rabia-akhtar/cat-wheel-print-plates/treat dispenser/main-cap-front.stl

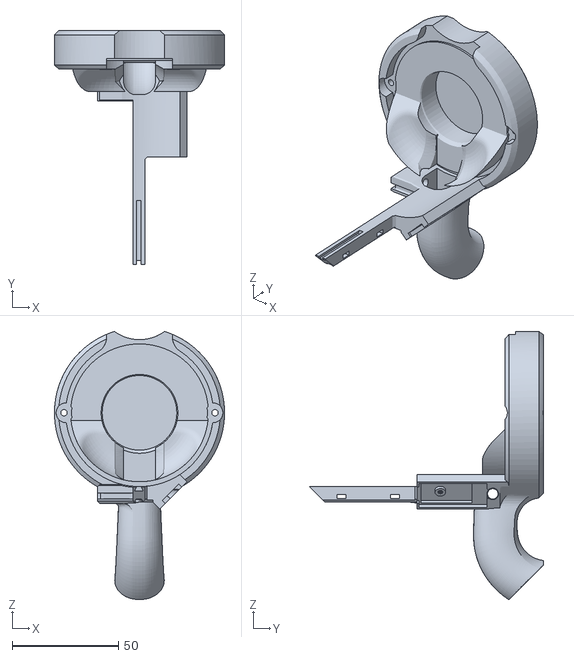
[picture p4: CAD file, 2026-05-28]
treat dispenser/main-cap-front.stl
80.0 x 109.8 x 126.0
