rabia-akhtar/cat-wheel-print-plates/treat dispenser/main-body.stl

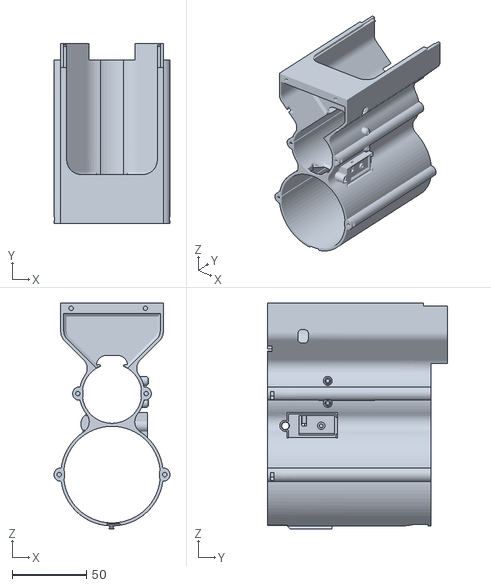
[picture p5: CAD file, 2026-05-28]
treat dispenser/main-body.stl
78.0 x 121.1 x 152.0
