rabia-akhtar/cat-wheel-print-plates/magnet sense/magnet_clip.stl

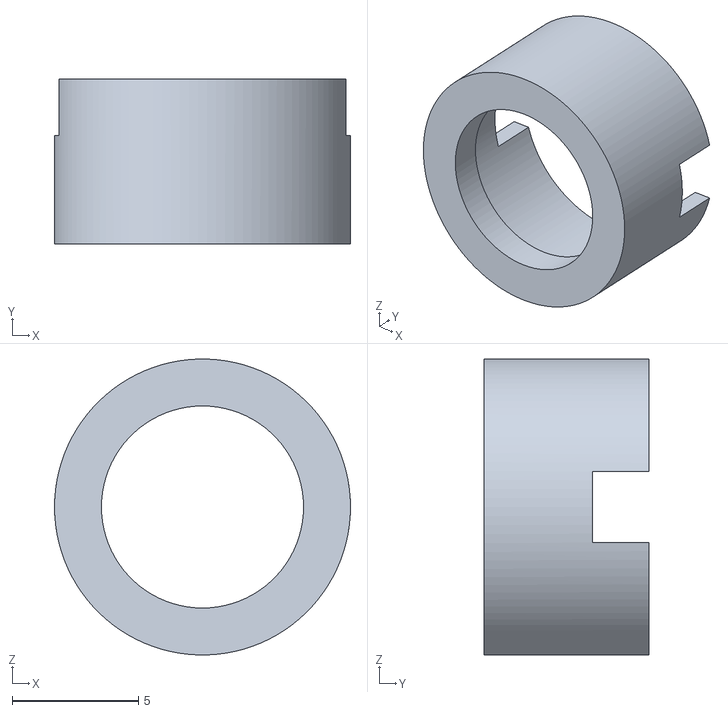
[picture p6: CAD file, 2026-05-28]
magnet sense/magnet_clip.stl
11.7 x 6.55 x 11.7
