rabia-akhtar/cat-wheel-print-plates/plates/plate_1.stl

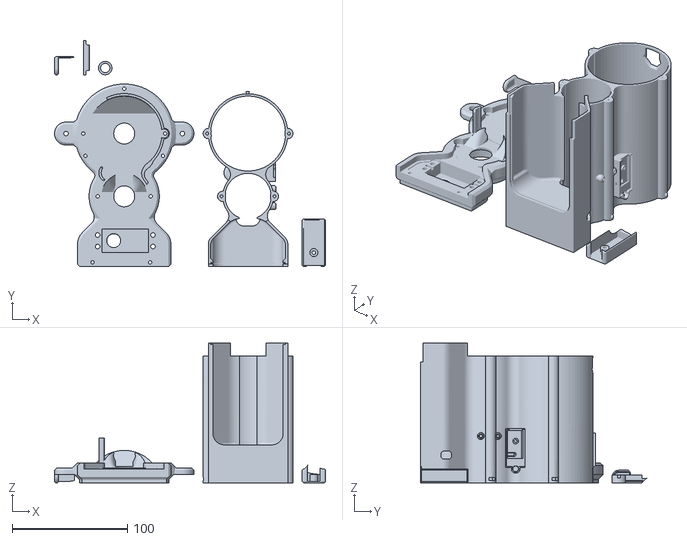
[picture p7: CAD file, 2026-05-28]
plates/plate_1.stl
235.2 x 196.2 x 121.1
