rabia-akhtar/cat-wheel-print-plates/treat dispenser/arduino-holder.stl

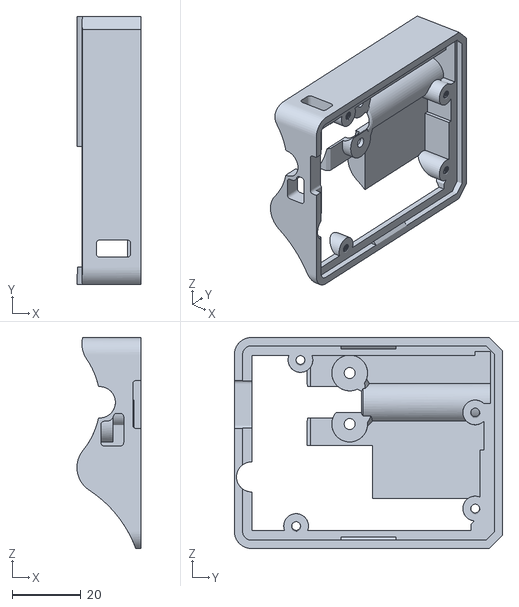
[picture p8: CAD file, 2026-05-28]
treat dispenser/arduino-holder.stl
18.6 x 78.0 x 61.3
