rabia-akhtar/cat-wheel-print-plates/wheel mount/letter-9-cat-t.stl

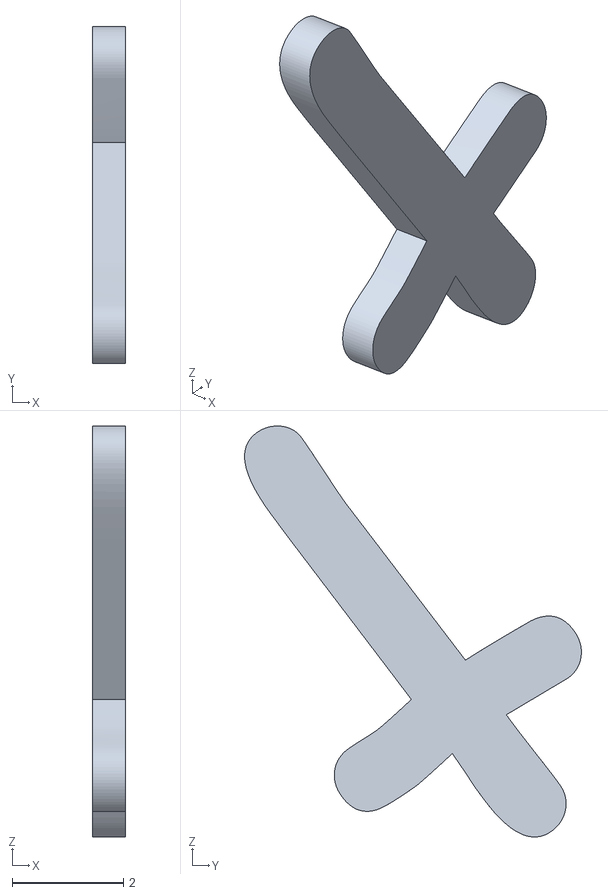
[picture p9: CAD file, 2026-05-28]
wheel mount/letter-9-cat-t.stl
0.6 x 6.05 x 7.38
