rabia-akhtar/cat-wheel-print-plates/magnet sense/hall_effect_holder.stl

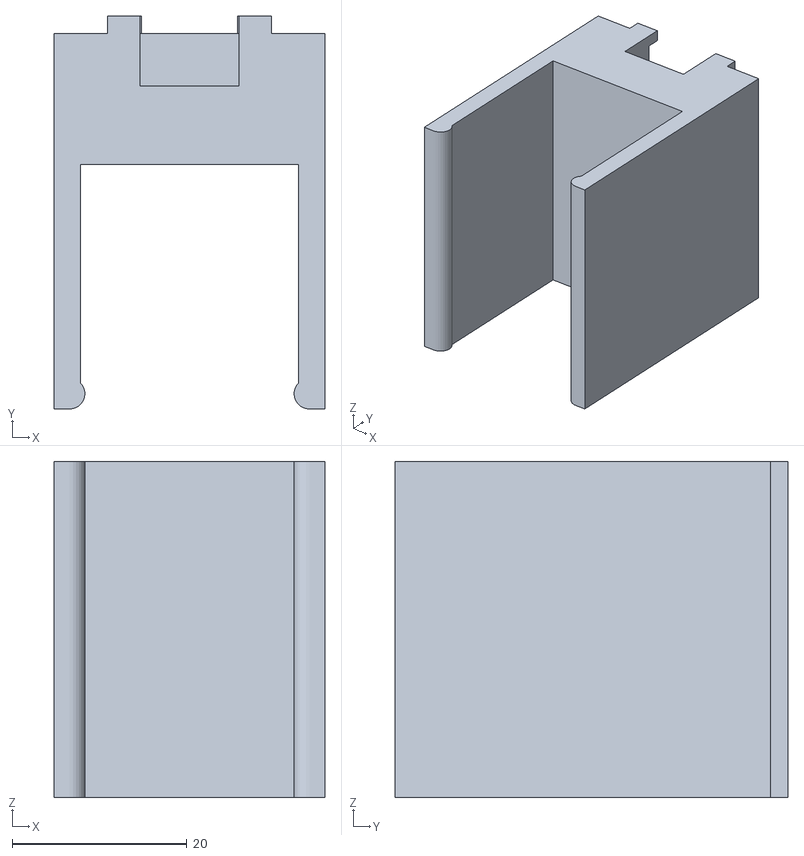
[picture p10: CAD file, 2026-05-28]
magnet sense/hall_effect_holder.stl
31.0 x 45.0 x 38.5
