rabia-akhtar/cat-wheel-print-plates/plates/plate_5.stl

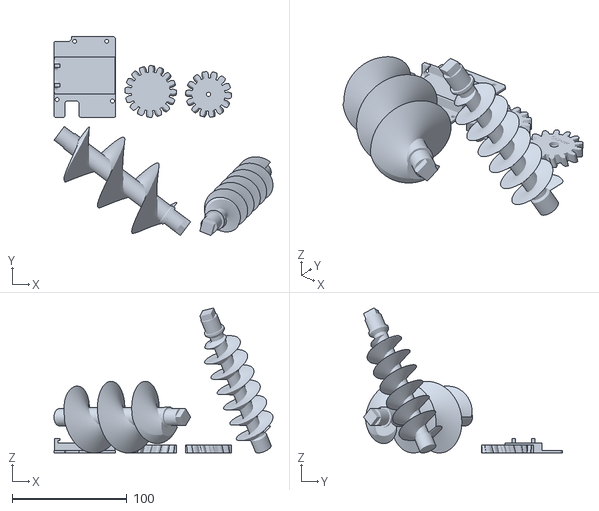
[picture p11: CAD file, 2026-05-28]
plates/plate_5.stl
190.9 x 173.5 x 126.4
