rabia-akhtar/cat-wheel-print-plates/treat dispenser/esp32-wroom-sled.stl

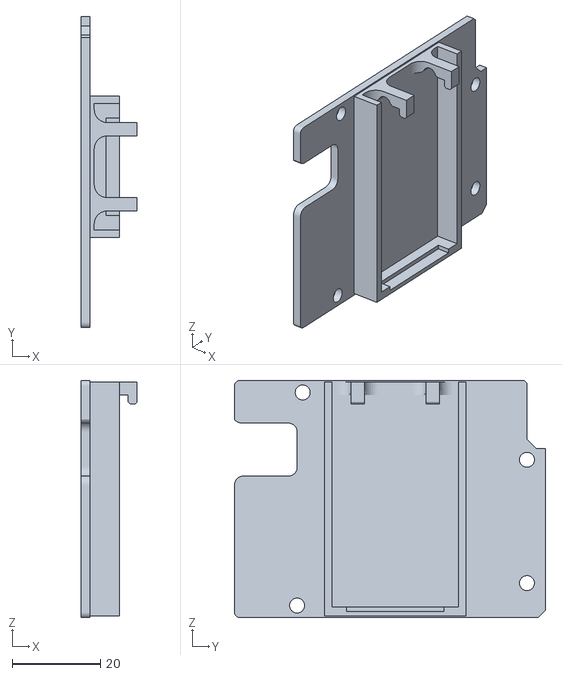
[picture p12: CAD file, 2026-05-28]
treat dispenser/esp32-wroom-sled.stl
12.7 x 70.4 x 53.7
