rabia-akhtar/cat-wheel-print-plates/wheel mount/front.stl

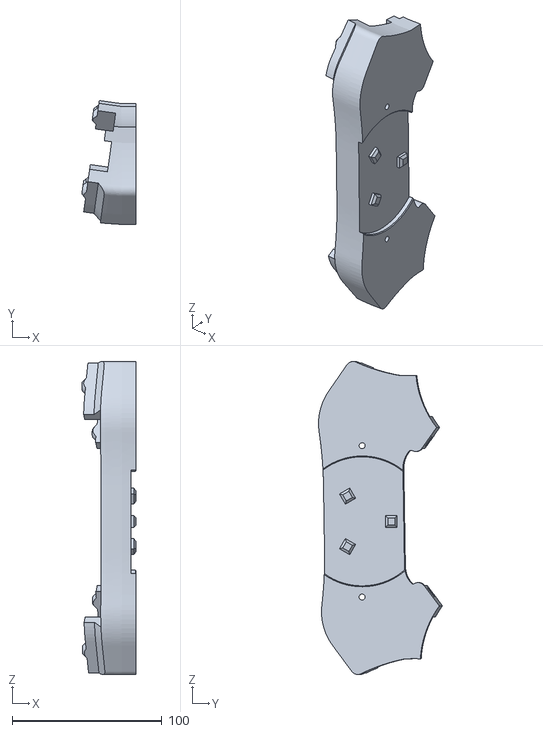
[picture p13: CAD file, 2026-05-28]
wheel mount/front.stl
36.3 x 82.7 x 208.9
