rabia-akhtar/cat-wheel-print-plates/plates/plate_4.stl

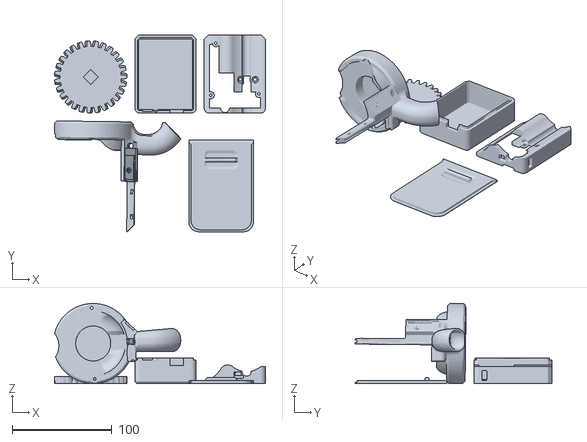
[picture p14: CAD file, 2026-05-28]
plates/plate_4.stl
211.2 x 196.7 x 80.1
