rabia-akhtar/cat-wheel-print-plates/treat dispenser/arduino-cover.stl

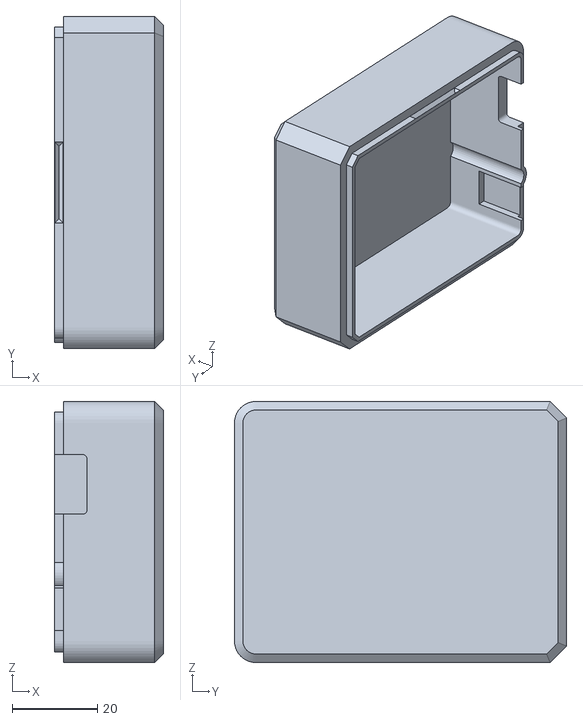
[picture p15: CAD file, 2026-05-28]
treat dispenser/arduino-cover.stl
25.5 x 78.0 x 61.3
