rabia-akhtar/cat-wheel-print-plates/wheel mount/letter-1-one-o.stl

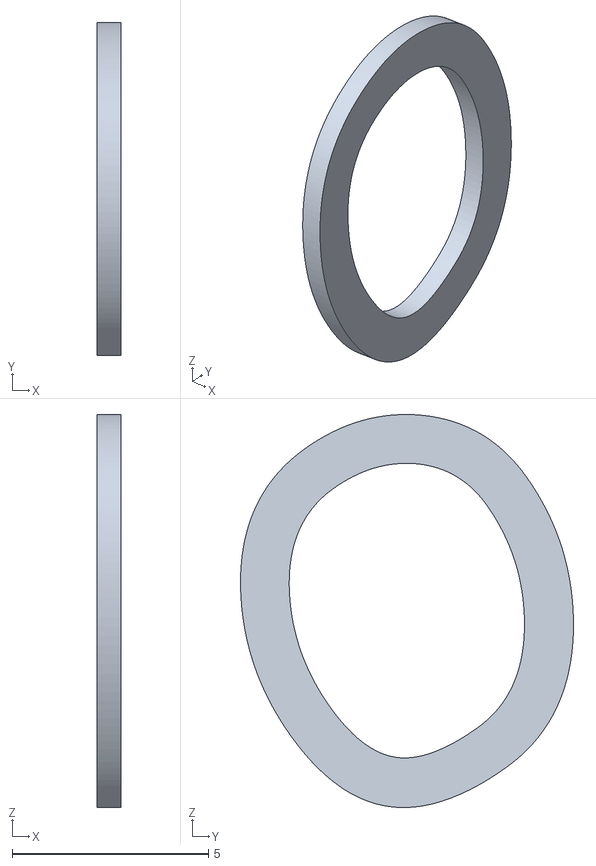
[picture p16: CAD file, 2026-05-28]
wheel mount/letter-1-one-o.stl
0.6 x 8.49 x 10.0
