rabia-akhtar/cat-wheel-print-plates/plates/plate_2.stl

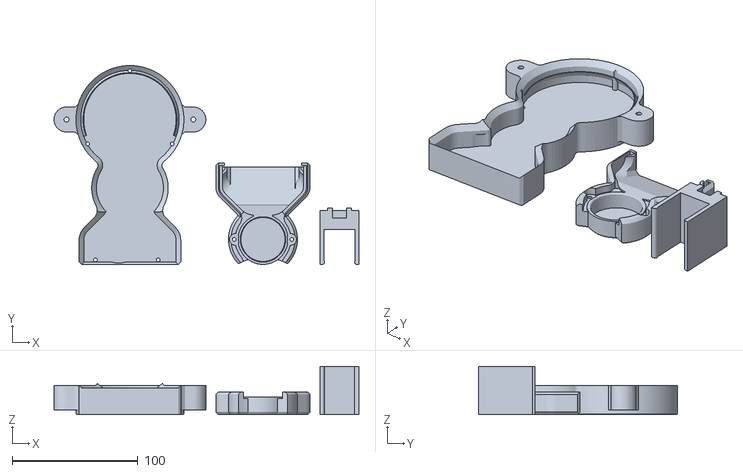
[picture p17: CAD file, 2026-05-28]
plates/plate_2.stl
243.0 x 158.4 x 38.5
