rabia-akhtar/cat-wheel-print-plates/wheel mount/back.stl

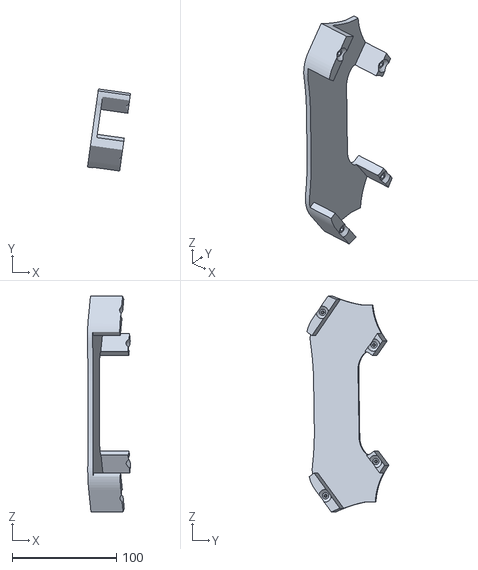
[picture p18: CAD file, 2026-05-28]
wheel mount/back.stl
41.3 x 78.7 x 207.0
