rabia-akhtar/cat-wheel-print-plates/plates/plate_3.stl

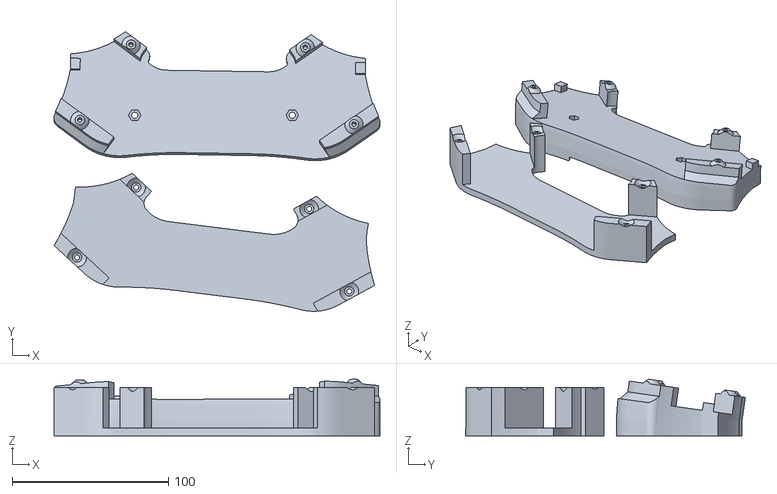
[picture p19: CAD file, 2026-05-28]
plates/plate_3.stl
208.9 x 179.3 x 36.3
