rabia-akhtar/cat-wheel-print-plates/treat dispenser/gear-cover.stl

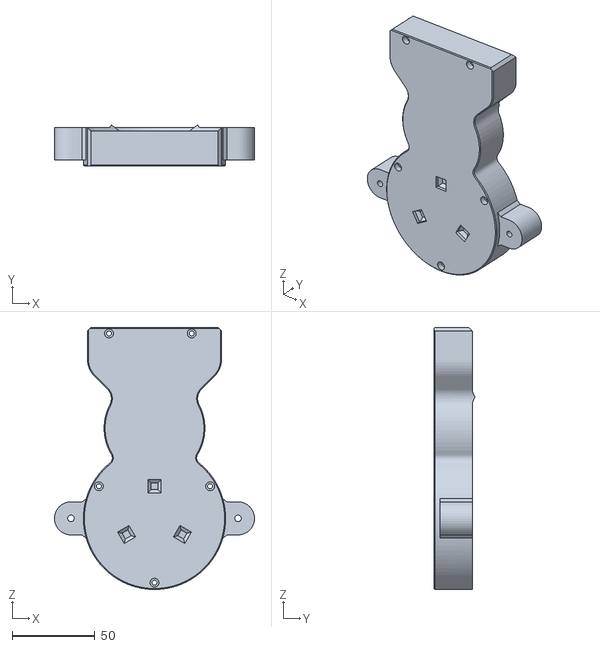
[picture p20: CAD file, 2026-05-28]
treat dispenser/gear-cover.stl
121.0 x 24.9 x 158.4
