rabia-akhtar/cat-wheel-print-plates/treat dispenser/bottom-gear.stl

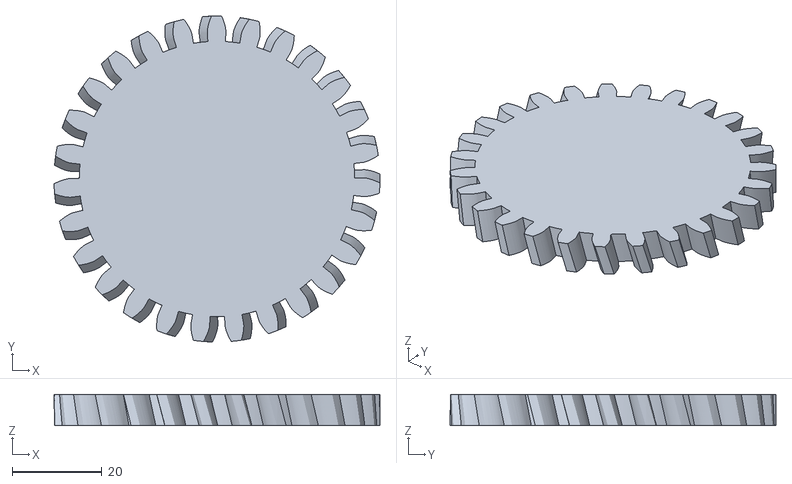
[picture p21: CAD file, 2026-05-28]
treat dispenser/bottom-gear.stl
72.5 x 72.5 x 7.00
