rabia-akhtar/cat-wheel-print-plates/wheel mount/letter-5-fat-a.stl

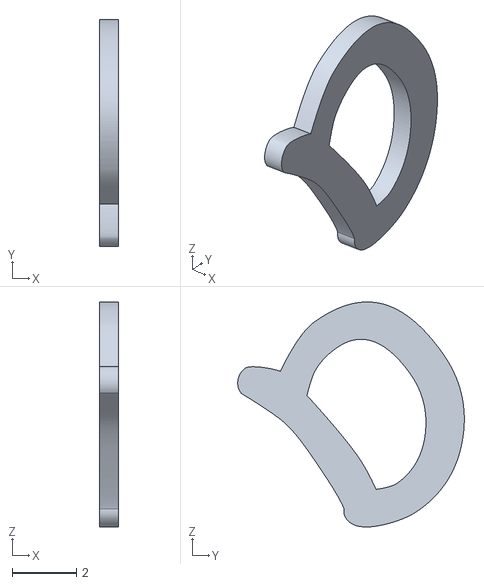
[picture p22: CAD file, 2026-05-28]
wheel mount/letter-5-fat-a.stl
0.6 x 7.08 x 7.03
