rabia-akhtar/cat-wheel-print-plates/treat dispenser/hopper-cap-front.stl

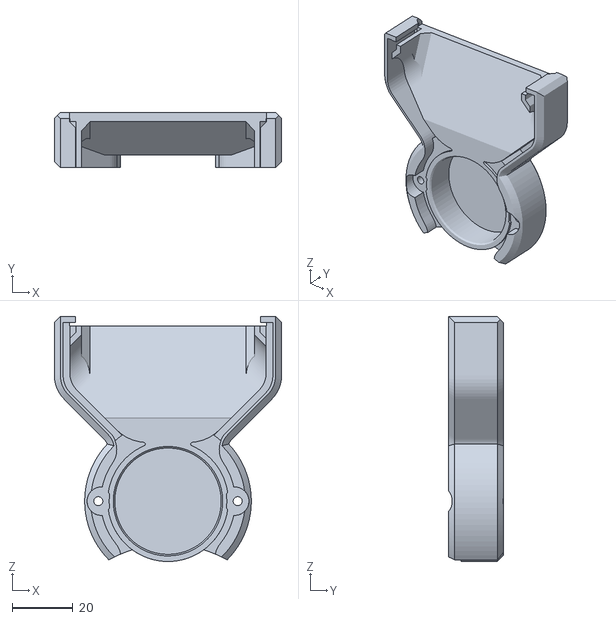
[picture p23: CAD file, 2026-05-28]
treat dispenser/hopper-cap-front.stl
75.0 x 18.1 x 80.8
