rabia-akhtar/cat-wheel-print-plates/wheel mount/letter-2-one-n.stl

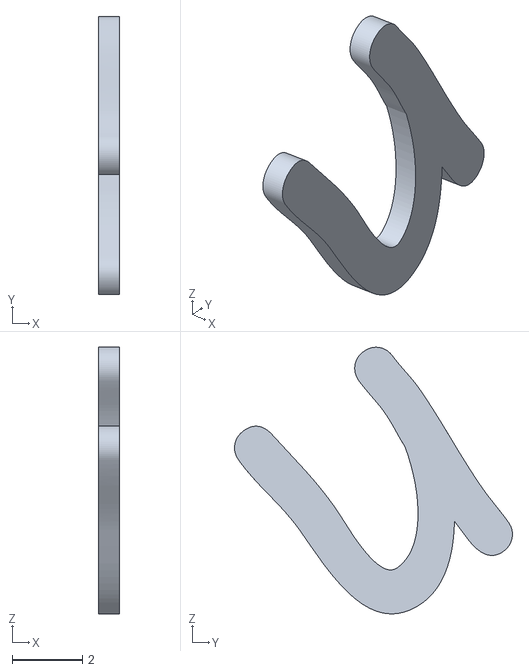
[picture p24: CAD file, 2026-05-28]
wheel mount/letter-2-one-n.stl
0.6 x 7.91 x 7.59
