rabia-akhtar/cat-wheel-print-plates/treat dispenser/drive-gear.stl

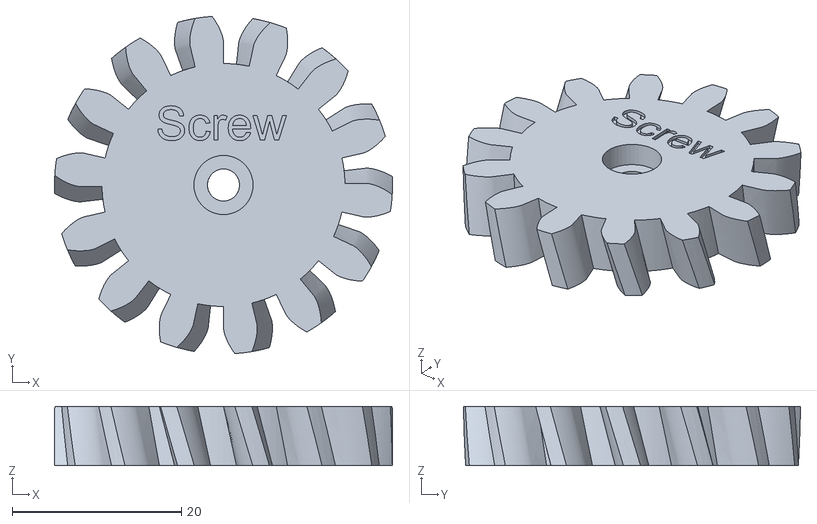
[picture p25: CAD file, 2026-05-28]
treat dispenser/drive-gear.stl
40.0 x 39.9 x 7.00
