rabia-akhtar/cat-wheel-print-plates/wheel mount/letter-7-cat-c.stl

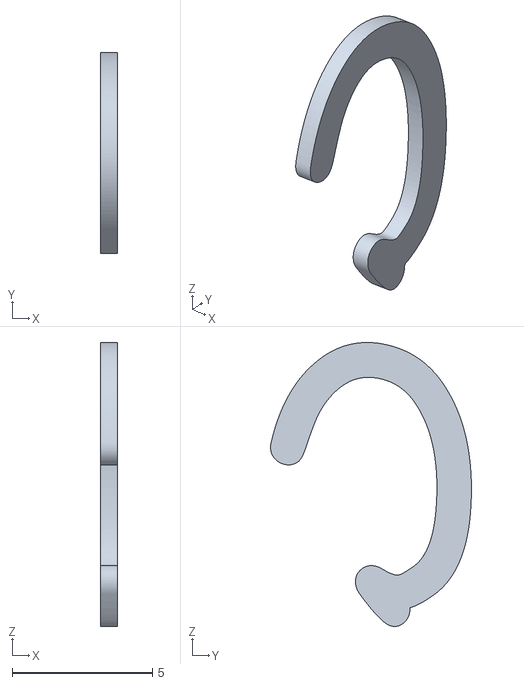
[picture p26: CAD file, 2026-05-28]
wheel mount/letter-7-cat-c.stl
0.6 x 7.17 x 10.1
