rabia-akhtar/cat-wheel-print-plates/treat dispenser/led-cover.stl

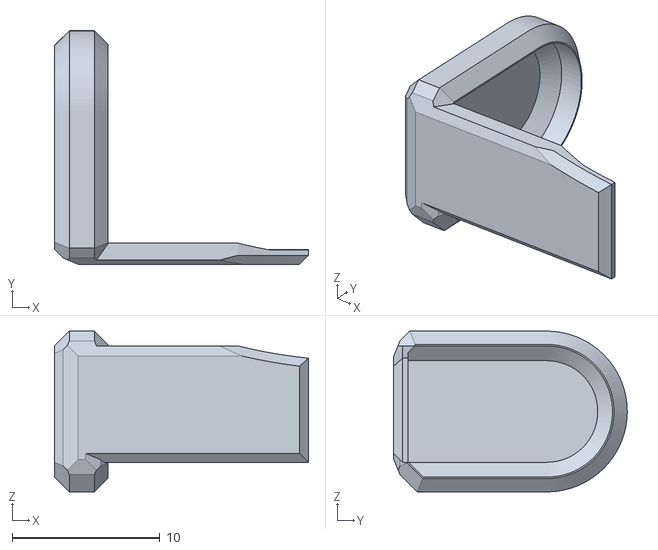
[picture p27: CAD file, 2026-05-28]
treat dispenser/led-cover.stl
17.2 x 15.8 x 10.9
