rabia-akhtar/cat-wheel-print-plates/treat dispenser/esp32-wroom-sled-clip.stl

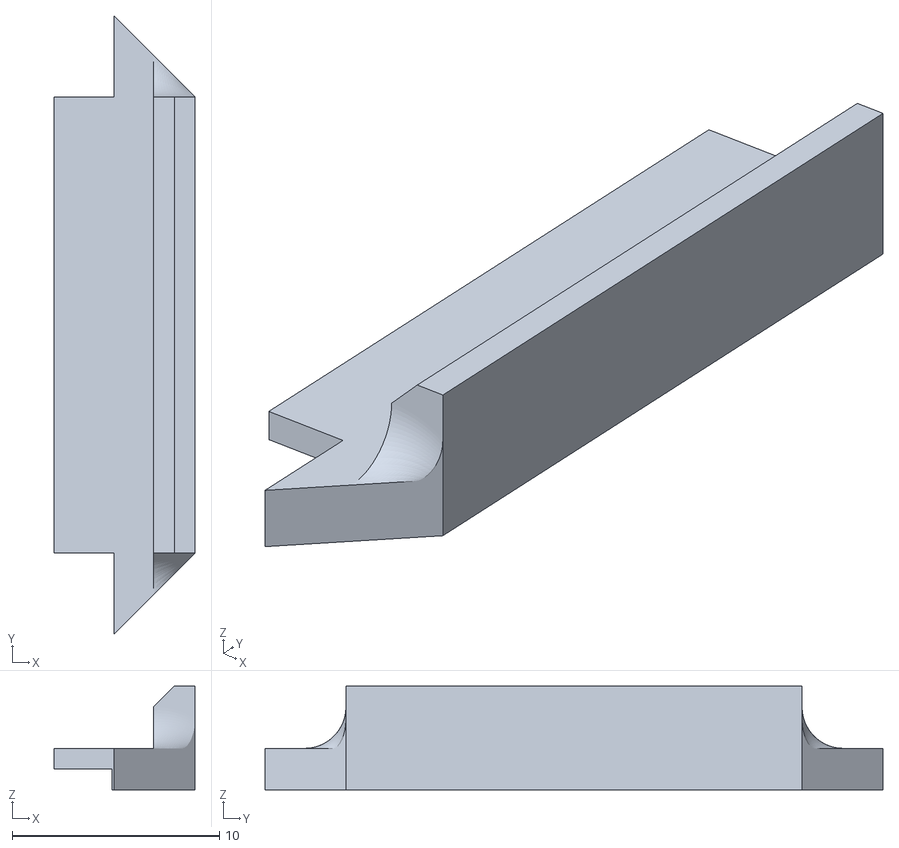
[picture p28: CAD file, 2026-05-28]
treat dispenser/esp32-wroom-sled-clip.stl
6.80 x 29.8 x 5.00
