rabia-akhtar/cat-wheel-print-plates/wheel mount/letter-3-one-e.stl

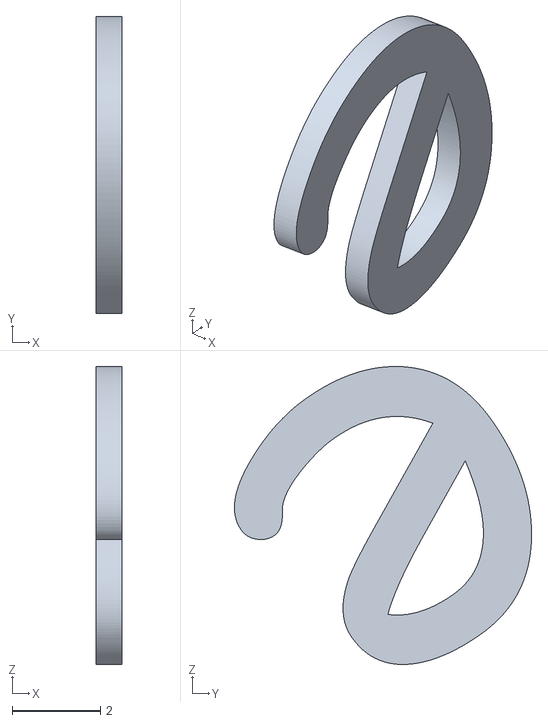
[picture p29: CAD file, 2026-05-28]
wheel mount/letter-3-one-e.stl
0.6 x 6.73 x 6.75
