rabia-akhtar/cat-wheel-print-plates/wheel mount/cat-mount-minimized.step

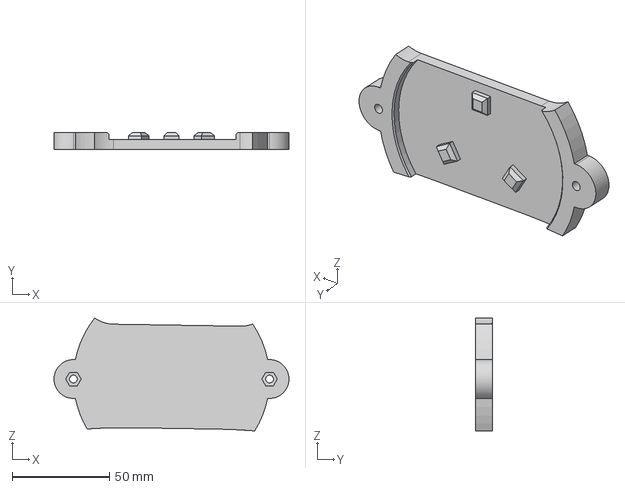
[picture p30: CAD file, 2026-05-28]
wheel mount/cat-mount-minimized.step
121.0 x 8.60 x 58.1 mm
