rabia-akhtar/cat-wheel-print-plates/treat dispenser/hopper-gear.stl

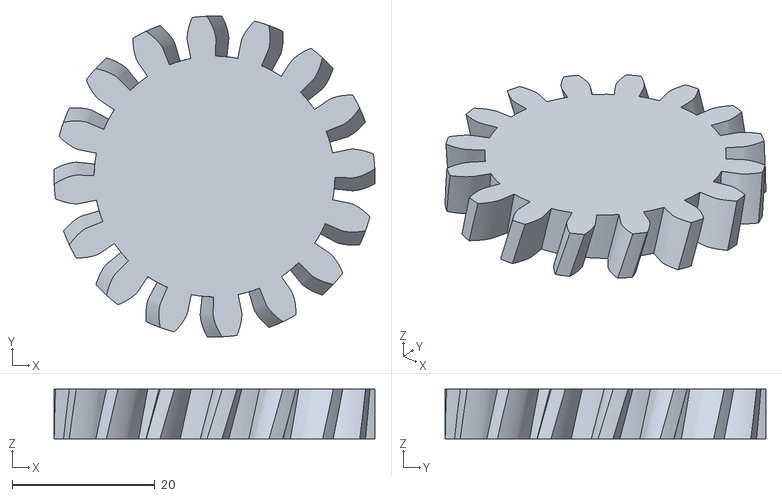
[picture p31: CAD file, 2026-05-28]
treat dispenser/hopper-gear.stl
45.0 x 45.0 x 7.00
