rabia-akhtar/cat-wheel-print-plates/wheel mount/letter-4-fat-f.stl

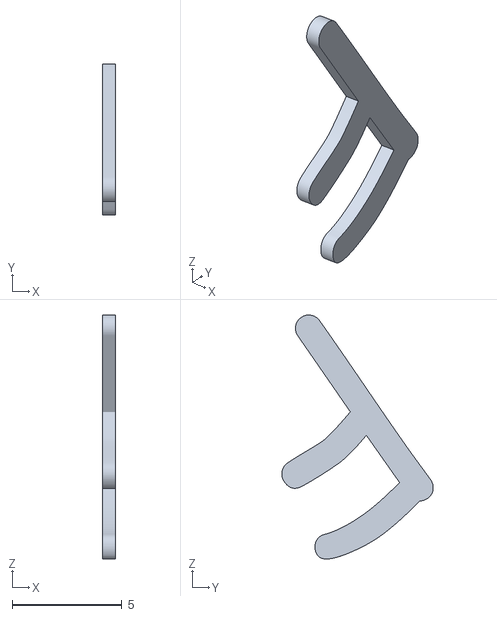
[picture p32: CAD file, 2026-05-28]
wheel mount/letter-4-fat-f.stl
0.6 x 6.91 x 11.1
