rabia-akhtar/cat-wheel-print-plates/treat dispenser/light-break-sensor-cover.stl

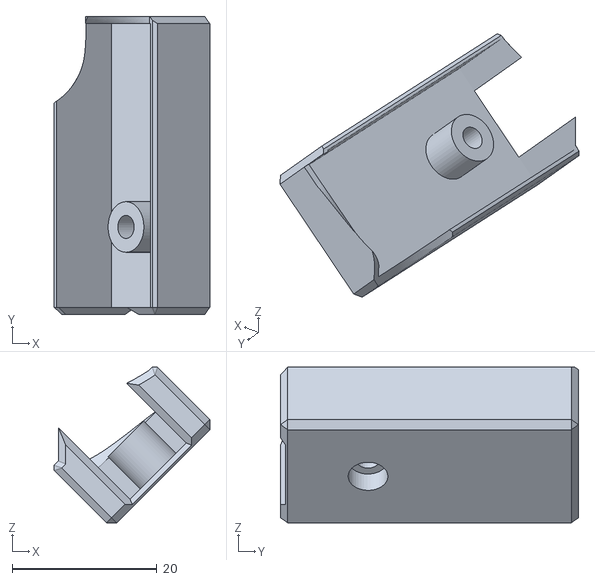
[picture p33: CAD file, 2026-05-28]
treat dispenser/light-break-sensor-cover.stl
21.5 x 41.2 x 21.5
