rabia-akhtar/cat-wheel-print-plates/treat dispenser/back-cap.stl

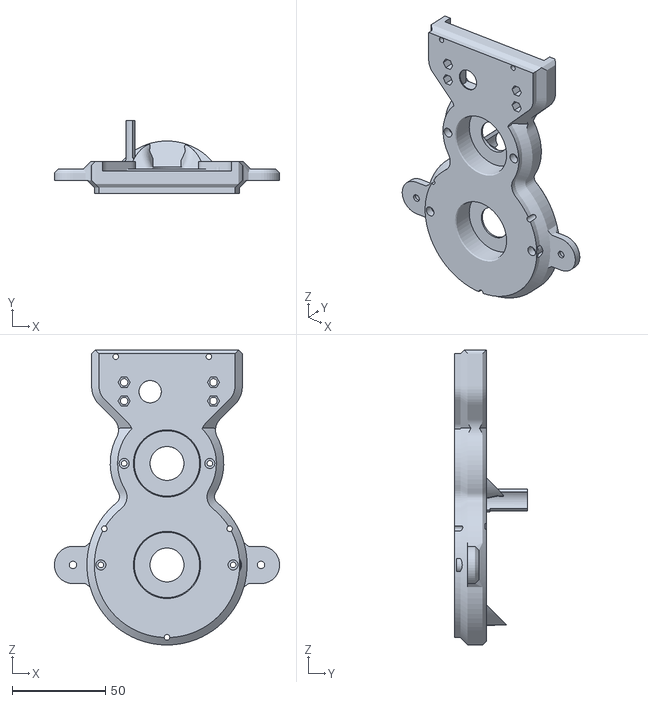
[picture p34: CAD file, 2026-05-28]
treat dispenser/back-cap.stl
121.0 x 39.0 x 158.4
