rabia-akhtar/cat-wheel-print-plates/treat dispenser/lid.stl

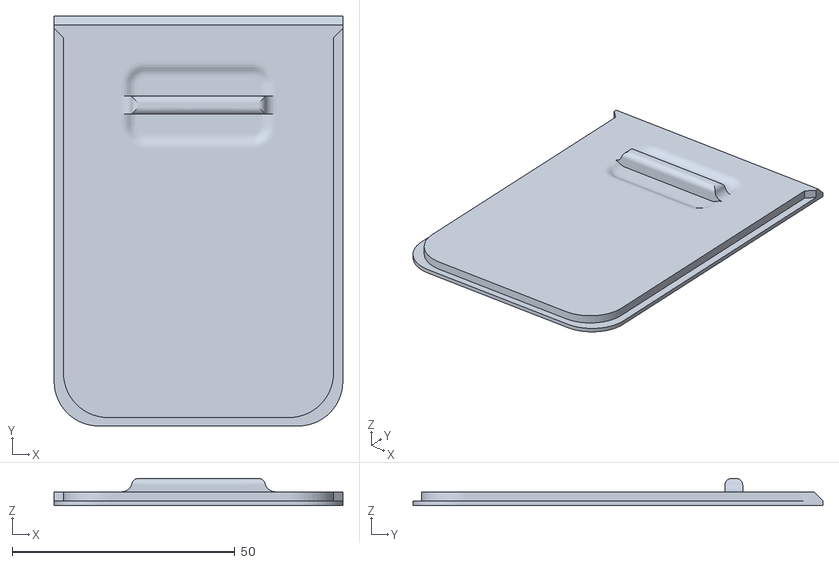
[picture p35: CAD file, 2026-05-28]
treat dispenser/lid.stl
64.8 x 92.0 x 6.10
