rabia-akhtar/cat-wheel-print-plates/(list of files, cad)

Other CAD files:
wheel mount/front_w_letters.stl
wheel mount/letter-6-fat-t.stl
wheel mount/letter-8-cat-a.stl
treat dispenser/bottom-screw.stl
treat dispenser/top-screw.stl
