rabia-akhtar/cat-wheel-print-plates/(commit log)

2026-05-28 Add oriented print plates and orientation script for cat wheel treat dispenser
    [plate_1.stl, plate_2.stl, plate_3.stl, plate_4.stl, plate_5.stl, plate_6.stl]
2026-05-28 Remove front_w_letters and letter parts, repack into 6 plates
    [arduino-cover.stl, arduino-holder.stl, back-cap.stl, back.stl, bottom-gear.stl, bottom-screw.stl, cat-mount-minimized.step, drive-gear.stl]
2026-05-28 Improve packing and use overhang-minimizing orientation algorithm
    [plate_1.stl, plate_2.stl, plate_3.stl, plate_4.stl, plate_5.stl, plate_6.stl]
2026-05-28 Accurate overhang-minimizing orientation: sphere fibonacci + coplanar clustering
    [plate_1.stl, plate_2.stl, plate_3.stl, plate_4.stl, plate_5.stl]
2026-05-28 Increase part spacing to 8mm to leave room for build plate supports
    [plate_1.stl, plate_2.stl, plate_3.stl, plate_4.stl, plate_5.stl]
2026-05-28 Fix floating parts: composite score penalises unstable edge-on-bed orientations
    [plate_1.stl, plate_2.stl, plate_3.stl, plate_4.stl, plate_5.stl]
